Levi--G/Biscuit/Schematic.md

# Schematic

The schematic schould be self explanatory, if you want an overview of what-does-what you can read the construction guide.

The schematic used in V1.0:

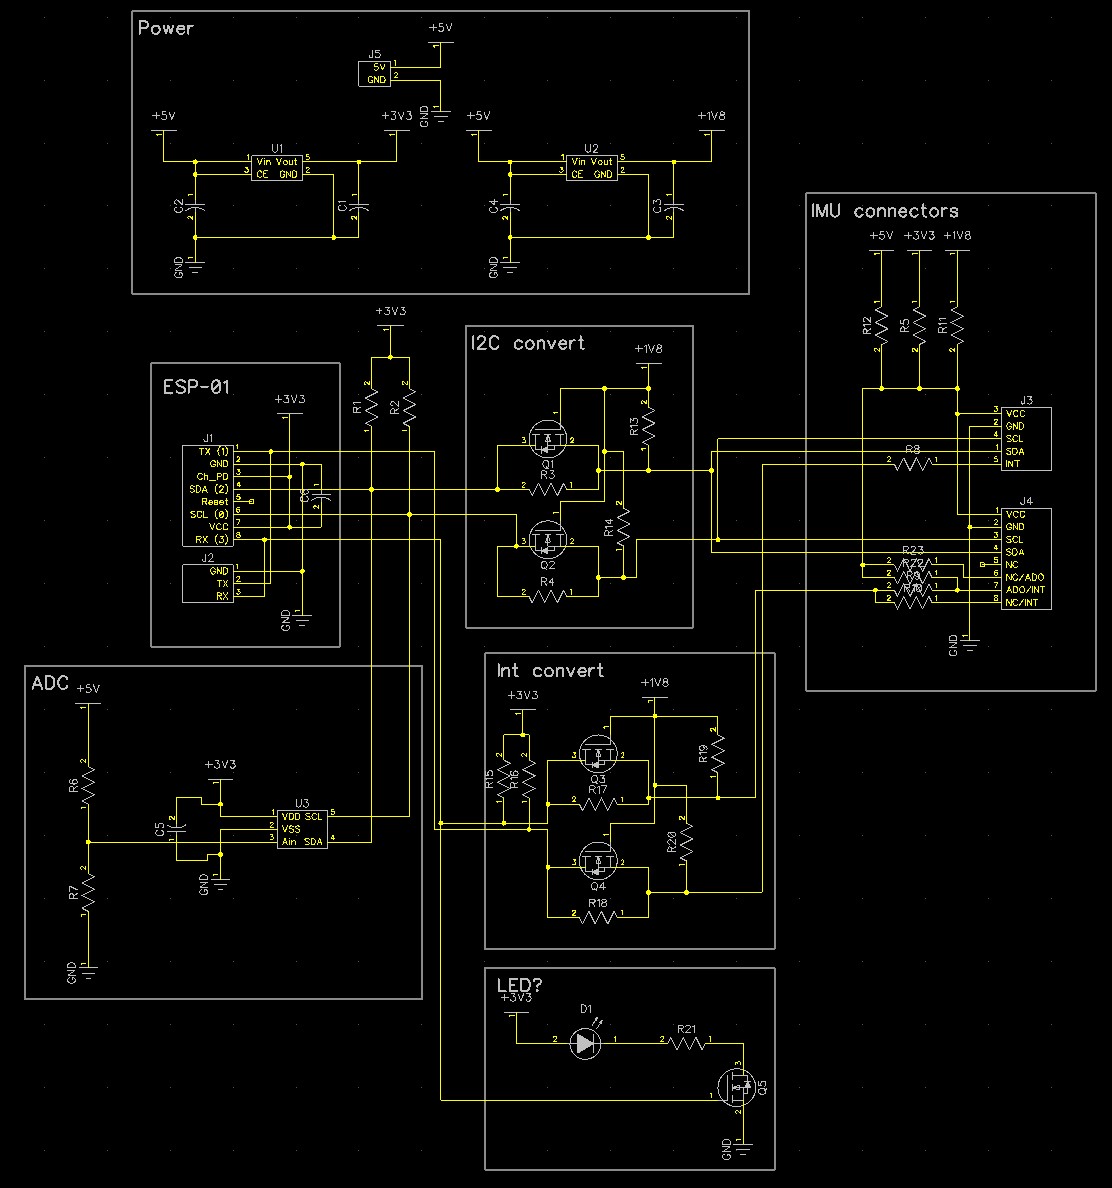
[picture p2: img/Schematic10.jpg]


A bare minimum schematic without INT, 1.8v compatibility, etc. would look smth like this:

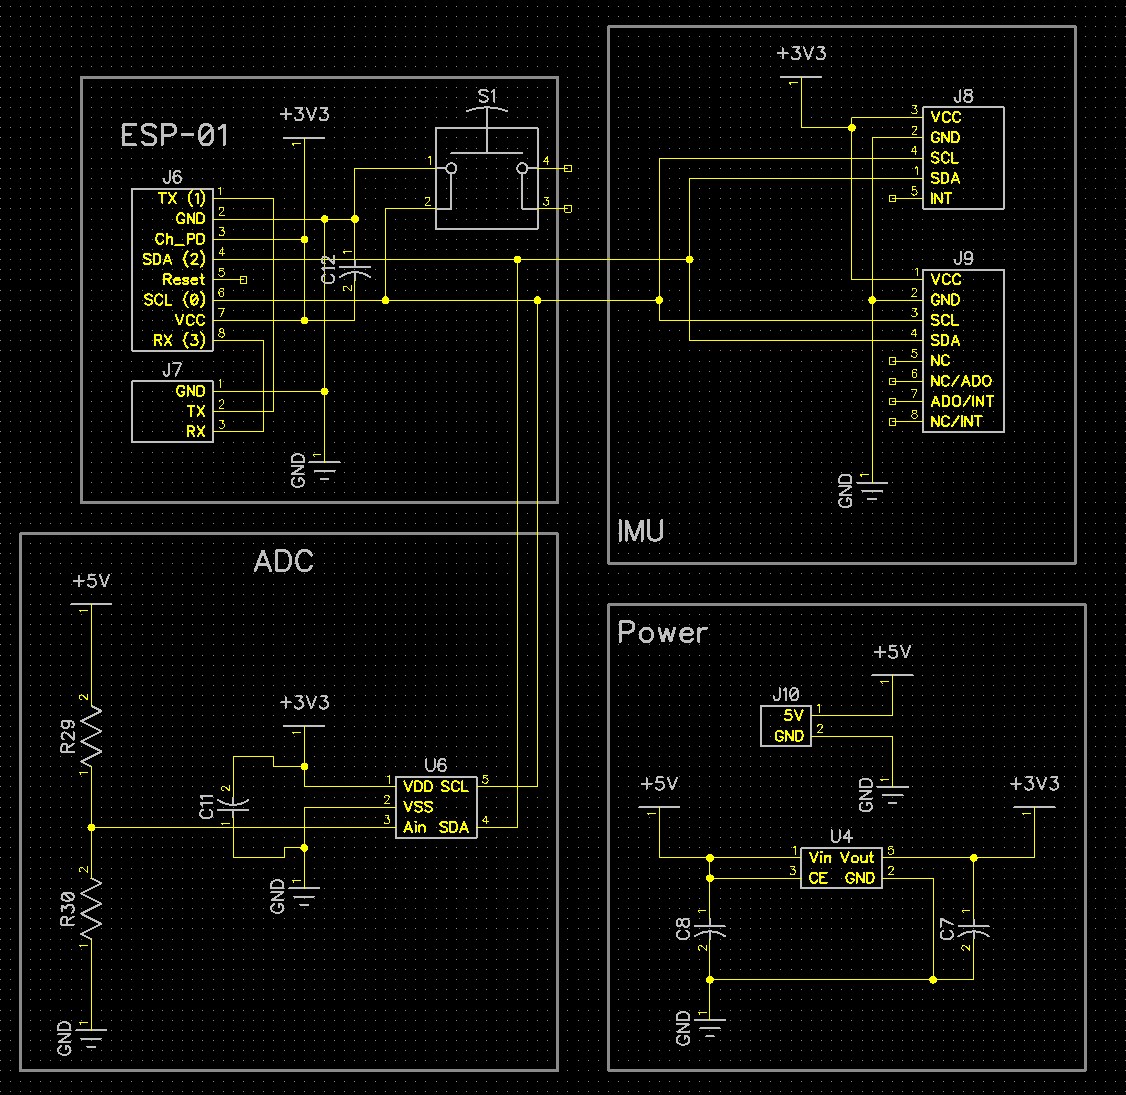
[picture p3: img/MinimumSchematic.jpg]
