Levi--G/Biscuit/(list of files, drawings)

Other design files:
pcb/Minimum.dch
pcb/PcbV1.dch
pcb/PcbV1.dip
